ikea-lisp-code/diodberg/schematics/README.md

# diodberg schematics

diodberg schematics require Eagle v6.3.0 or later

...filenames will be cleaned up soon...

# Questions? 

Email <chris@notspelledright.com>, <yuanyu.chen@gmail.com>
