ikea-lisp-code/diodberg/schematics/dmx_splitter.brd

## EAGLE design schematics/dmx_splitter.brd (2013-07-26)

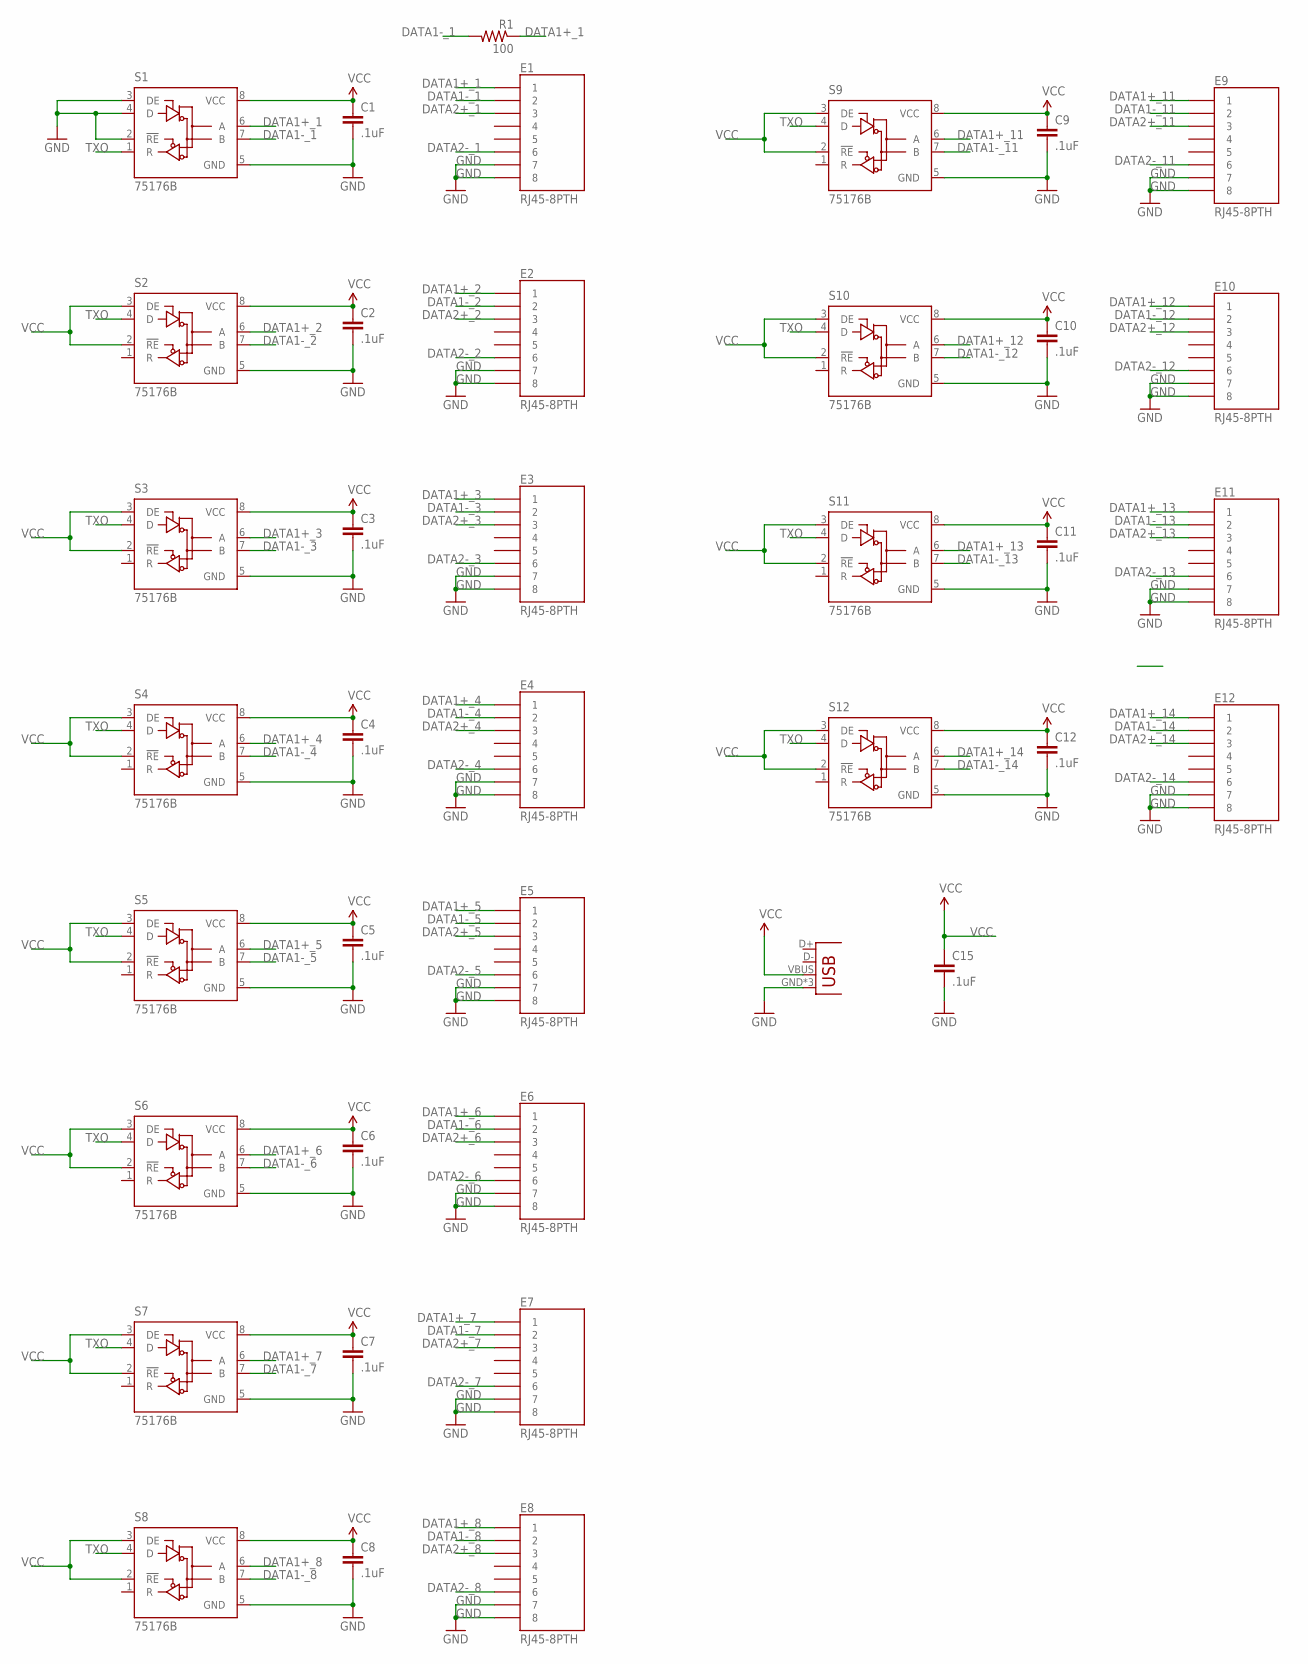
[picture p1: schematic dmx_splitter.sch]

Parts:
C1, C2, C3, C4, C5, C6, C7, C8, C9, C10, C11, C12, C15: .1uF; 0402-CAP
E1, E2, E3, E4, E5, E6, E7, E8, E9, E10, E11, E12: RJ45-8PTH; RJ45-8
JP1: USB-MICROB
R1: 100; 1206
S1, S2, S3, S4, S5, S6, S7, S8, S9, S10, S11, S12: 75176B; D_R-PDSO-G8

Connections:
DATA1+_1: E1.1, R1.1, S1.6 (A)
DATA1+_2: E2.1, S2.6 (A)
DATA1+_3: E3.1, S3.6 (A)
DATA1+_4: E4.1, S4.6 (A)
DATA1+_5: E5.1, S5.6 (A)
DATA1+_6: E6.1, S6.6 (A)
DATA1+_7: E7.1, S7.6 (A)
DATA1+_8: E8.1, S8.6 (A)
DATA1+_11: E9.1, S9.6 (A)
DATA1+_12: E10.1, S10.6 (A)
DATA1+_13: E11.1, S11.6 (A)
DATA1+_14: E12.1, S12.6 (A)
DATA1-_1: E1.2, R1.2, S1.7 (B)
DATA1-_2: E2.2, S2.7 (B)
DATA1-_3: E3.2, S3.7 (B)
DATA1-_4: E4.2, S4.7 (B)
DATA1-_5: E5.2, S5.7 (B)
DATA1-_6: E6.2, S6.7 (B)
DATA1-_7: E7.2, S7.7 (B)
DATA1-_8: E8.2, S8.7 (B)
DATA1-_11: E9.2, S9.7 (B)
DATA1-_12: E10.2, S10.7 (B)
DATA1-_13: E11.2, S11.7 (B)
DATA1-_14: E12.2, S12.7 (B)
DATA2+_1: E1.3
DATA2+_2: E2.3
DATA2+_3: E3.3
DATA2+_4: E4.3
DATA2+_5: E5.3
DATA2+_6: E6.3
DATA2+_7: E7.3
DATA2+_8: E8.3
DATA2+_11: E9.3
DATA2+_12: E10.3
DATA2+_13: E11.3
DATA2+_14: E12.3
DATA2-_1: E1.6
DATA2-_2: E2.6
DATA2-_3: E3.6
DATA2-_4: E4.6
DATA2-_5: E5.6
DATA2-_6: E6.6
DATA2-_7: E7.6
DATA2-_8: E8.6
DATA2-_11: E9.6
DATA2-_12: E10.6
DATA2-_13: E11.6
DATA2-_14: E12.6
GND: C1.2, C2.2, C3.2, C4.2, C5.2, C6.2, C7.2, C8.2, C9.2, C10.2, C11.2, C12.2, C15.2, E1.7, E1.8, E2.7, E2.8, E3.7, E3.8, E4.7, E4.8, E5.7, E5.8, E6.7, E6.8, E7.7, E7.8, E8.7, E8.8, E9.7, E9.8, E10.7, E10.8, E11.7, E11.8, E12.7, E12.8, JP1.GND, JP1.MT1 (GND), JP1.MT2 (GND), S1.2 (!RE), S1.3 (DE), S1.4 (D), S1.5 (GND), S2.5 (GND), S3.5 (GND), S4.5 (GND), S5.5 (GND), S6.5 (GND), S7.5 (GND), S8.5 (GND), S9.5 (GND), S10.5 (GND), S11.5 (GND), S12.5 (GND)
TXO: S1.1 (R), S2.4 (D), S3.4 (D), S4.4 (D), S5.4 (D), S6.4 (D), S7.4 (D), S8.4 (D), S9.4 (D), S10.4 (D), S11.4 (D), S12.4 (D)
VCC: C1.1, C2.1, C3.1, C4.1, C5.1, C6.1, C7.1, C8.1, C9.1, C10.1, C11.1, C12.1, C15.1, JP1.VBUS, S1.8 (VCC), S2.2 (!RE), S2.3 (DE), S2.8 (VCC), S3.2 (!RE), S3.3 (DE), S3.8 (VCC), S4.2 (!RE), S4.3 (DE), S4.8 (VCC), S5.2 (!RE), S5.3 (DE), S5.8 (VCC), S6.2 (!RE), S6.3 (DE), S6.8 (VCC), S7.2 (!RE), S7.3 (DE), S7.8 (VCC), S8.2 (!RE), S8.3 (DE), S8.8 (VCC), S9.2 (!RE), S9.3 (DE), S9.8 (VCC), S10.2 (!RE), S10.3 (DE), S10.8 (VCC), S11.2 (!RE), S11.3 (DE), S11.8 (VCC), S12.2 (!RE), S12.3 (DE), S12.8 (VCC)

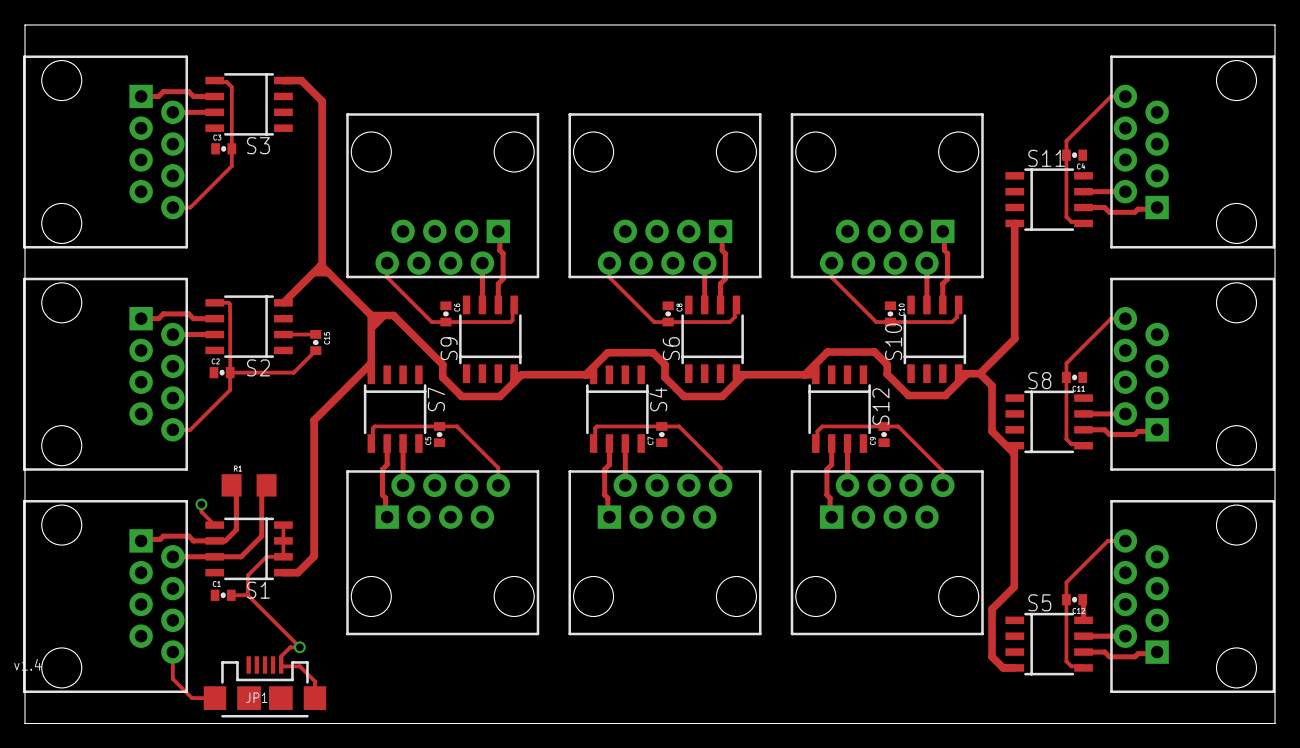
[picture p2: board dmx_splitter.brd from above]

Board: 2 copper layers, 100.0 x 55.9 mm, 39 parts (0 on the bottom side), 27 nets.
