ikea-lisp-code/diodberg/schematics/control_board_WS2812.brd

## EAGLE design schematics/control_board_WS2812.brd (2013-07-20)

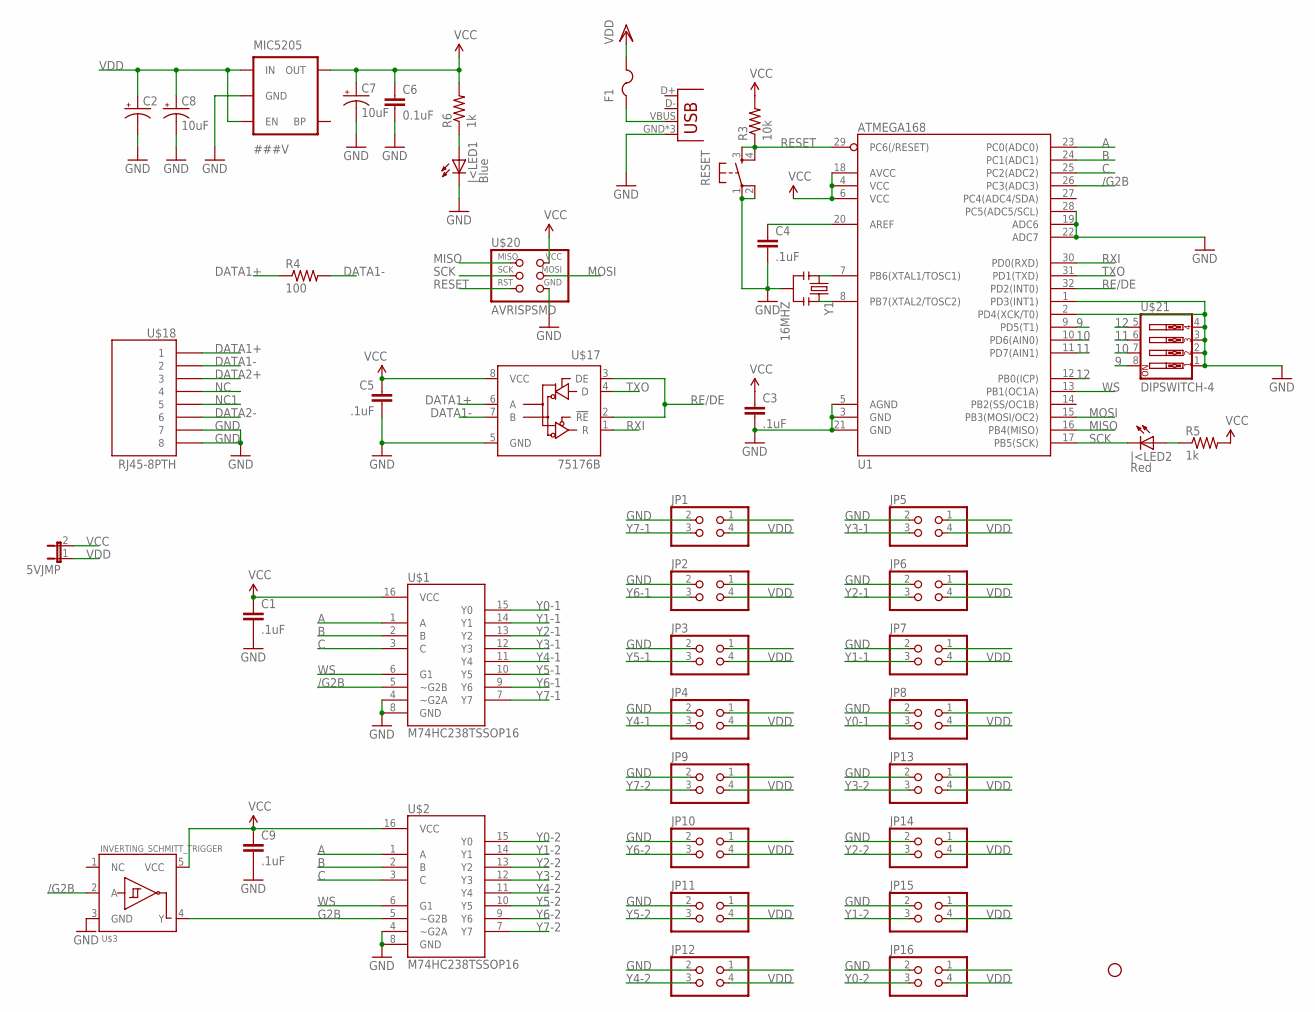
[picture p3: schematic control_board_WS2812.sch]

Parts:
5VJMP: JUMPER-2SMD-NO; SJ_2S-NO
C1, C3, C4, C5, C9: .1uF; 0402-CAP
C2: CAP_POLC; PANASONIC_C
C6: 0.1uF; 0402-CAP
C7, C8: 10uF; EIA3216
F1: PTCFUSE-1812; 1812
JP1, JP2, JP3, JP4, JP5, JP6, JP7, JP8, JP9, JP10, JP11, JP12, JP13, JP14, JP15, JP16: PINHD-2X2; 2X02
JP17: USB-MICROB
MIC5205: ###V; SOT23-5
R3: 10k; 0402-RES
R4: 100; 1206
R5, R6: 1k; C0402
RESET: TAC_SWITCHSMD; TACTILE_SWITCH_SMD
STANDOFF1: STAND-OFF
U1: ATMEGA168; TQFP32-08
U$1, U$2: M74HC238TSSOP16; TSSOP16
U$3: INVERTING_SCHMITT_TRIGGER; TSSOP5
U$17: 75176B; D_R-PDSO-G8
U$18: RJ45-8PTH; RJ45-8
U$20: AVRISPSMD; 2X03SMD
U$21: DIPSWITCH-4; DIPSWITCH-04
Y1: 16MHZ; RESONATOR-SMD
|<LED1: Blue; LED-0603
|<LED2: Red; LED-0603

Connections:
9: U1.9 (PD5(T1)), U$21.8
10: U1.10 (PD6(AIN0)), U$21.7
11: U1.11 (PD7(AIN1)), U$21.6
12: U1.12 (PB0(ICP)), U$21.5
/G2B: U1.26 (PC3(ADC3)), U$1.5 (~G2B), U$3.2 (A)
A: U1.23 (PC0(ADC0)), U$1.1 (A), U$2.1 (A)
B: U1.24 (PC1(ADC1)), U$1.2 (B), U$2.2 (B)
C: U1.25 (PC2(ADC2)), U$1.3 (C), U$2.3 (C)
DATA1+: R4.1, U$17.6 (A), U$18.1
DATA1-: R4.2, U$17.7 (B), U$18.2
DATA2+: U$18.3
DATA2-: U$18.6
G2B: U$2.5 (~G2B), U$3.4 (Y)
GND: C1.2, C2.-, C3.2, C4.2, C5.2, C6.2, C7.C (-), C8.C (-), C9.2, JP1.2, JP2.2, JP3.2, JP4.2, JP5.2, JP6.2, JP7.2, JP8.2, JP9.2, JP10.2, JP11.2, JP12.2, JP13.2, JP14.2, JP15.2, JP16.2, JP17.GND, JP17.MT1 (GND), JP17.MT2 (GND), MIC5205.2 (GND), RESET.1, RESET.2, U1.1 (PD3(INT1)), U1.2 (PD4(XCK/T0)), U1.3 (GND), U1.5 (AGND), U1.19 (ADC6), U1.21 (GND), U1.22 (ADC7), U1.28 (PC5(ADC5/SCL)), U$1.4 (~G2A), U$1.8 (GND), U$2.4 (~G2A), U$2.8 (GND), U$3.3 (GND), U$17.5 (GND), U$18.7, U$18.8, U$20.6 (GND), U$21.1, U$21.2, U$21.3, U$21.4, Y1.2, |<LED1.C
MISO: U1.16 (PB4(MISO)), U$20.1 (MISO)
MOSI: U1.15 (PB3(MOSI/OC2)), U$20.4 (MOSI)
unnamed: C4.1, U1.20 (AREF)
unnamed: U1.7 (PB6(XTAL1/TOSC1)), Y1.1
unnamed: U1.8 (PB7(XTAL2/TOSC2)), Y1.3
unnamed: R5.1, |<LED2.A
unnamed: F1.1, JP17.VBUS
unnamed: R6.1, |<LED1.A
NC: U$18.4
NC1: U$18.5
RE/DE: U1.32 (PD2(INT0)), U$17.2 (!RE), U$17.3 (DE)
RESET: R3.1, RESET.3, RESET.4, U1.29 (PC6(/RESET)), U$20.5 (RST)
RXI: U1.30 (PD0(RXD)), U$17.1 (R)
SCK: U1.17 (PB5(SCK)), U$20.3 (SCK), |<LED2.C
TXO: U1.31 (PD1(TXD)), U$17.4 (D)
VCC: 5VJMP.2, C1.1, C3.1, C5.1, C6.1, C7.A (+), C9.1, MIC5205.5 (OUT), R3.2, R5.2, R6.2, U1.4 (VCC), U1.6 (VCC), U1.18 (AVCC), U$1.16 (VCC), U$2.16 (VCC), U$3.5 (VCC), U$17.8 (VCC), U$20.2 (VCC)
VDD: 5VJMP.1, C2.+, C8.A (+), F1.2, JP1.4, JP2.4, JP3.4, JP4.4, JP5.4, JP6.4, JP7.4, JP8.4, JP9.4, JP10.4, JP11.4, JP12.4, JP13.4, JP14.4, JP15.4, JP16.4, MIC5205.1 (IN), MIC5205.3 (EN)
WS: U1.13 (PB1(OC1A)), U$1.6 (G1), U$2.6 (G1)
Y0-1: JP8.3, U$1.15 (Y0)
Y0-2: JP16.3, U$2.15 (Y0)
Y1-1: JP7.3, U$1.14 (Y1)
Y1-2: JP15.3, U$2.14 (Y1)
Y2-1: JP6.3, U$1.13 (Y2)
Y2-2: JP14.3, U$2.13 (Y2)
Y3-1: JP5.3, U$1.12 (Y3)
Y3-2: JP13.3, U$2.12 (Y3)
Y4-1: JP4.3, U$1.11 (Y4)
Y4-2: JP12.3, U$2.11 (Y4)
Y5-1: JP3.3, U$1.10 (Y5)
Y5-2: JP11.3, U$2.10 (Y5)
Y6-1: JP2.3, U$1.9 (Y6)
Y6-2: JP10.3, U$2.9 (Y6)
Y7-1: JP1.3, U$1.7 (Y7)
Y7-2: JP9.3, U$2.7 (Y7)

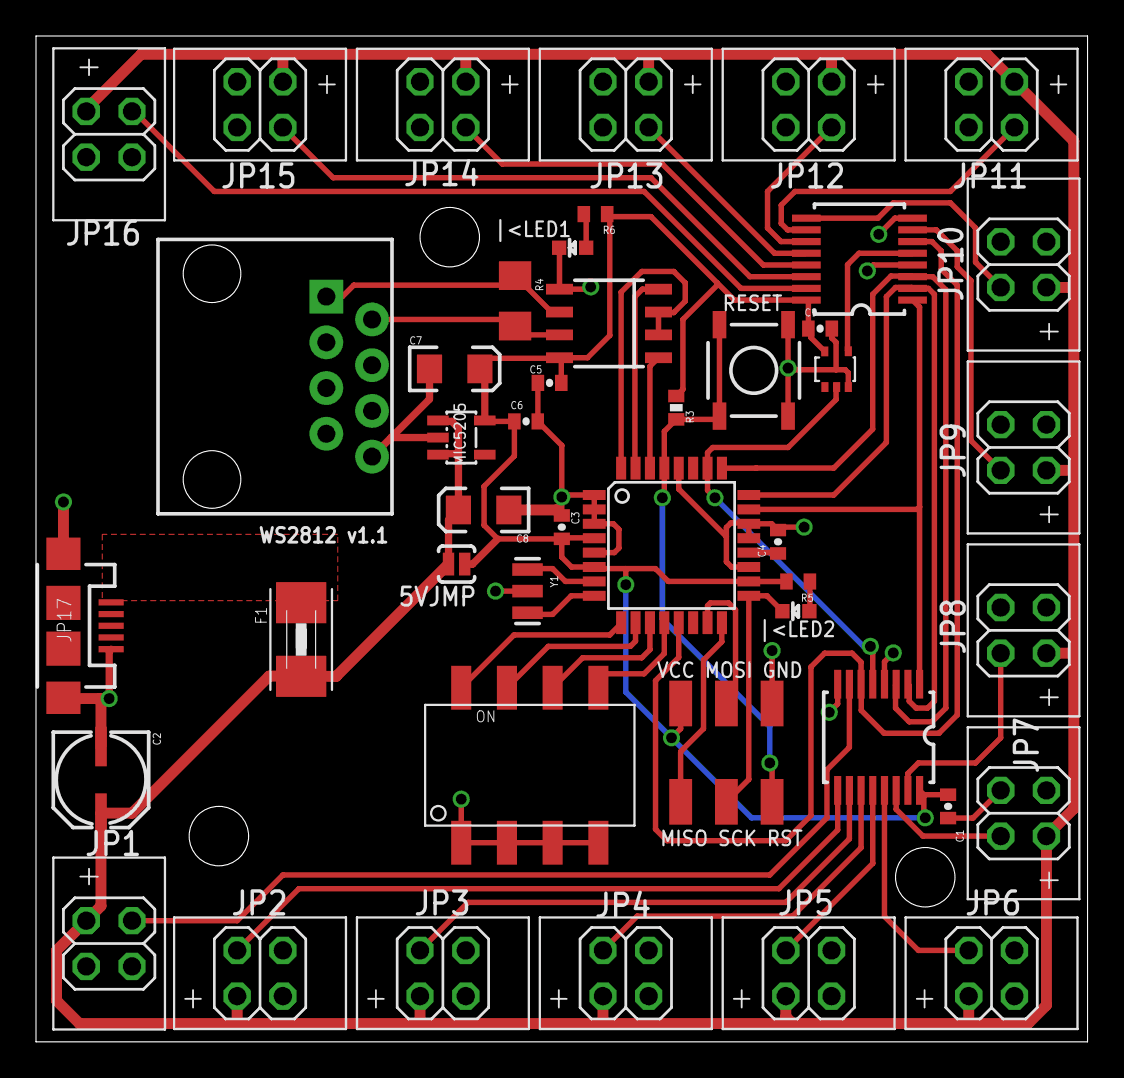
[picture p4: board control_board_WS2812.brd from above]

Board: 2 copper layers, 58.4 x 55.9 mm, 48 parts (0 on the bottom side), 44 nets.

Other parts of the board:
STANDOFF2, STANDOFF3: STAND-OFF
