ikea-lisp-code/diodberg/schematics/climbing_WS2812.brd

## EAGLE design schematics/climbing_WS2812.brd (2013-07-14)

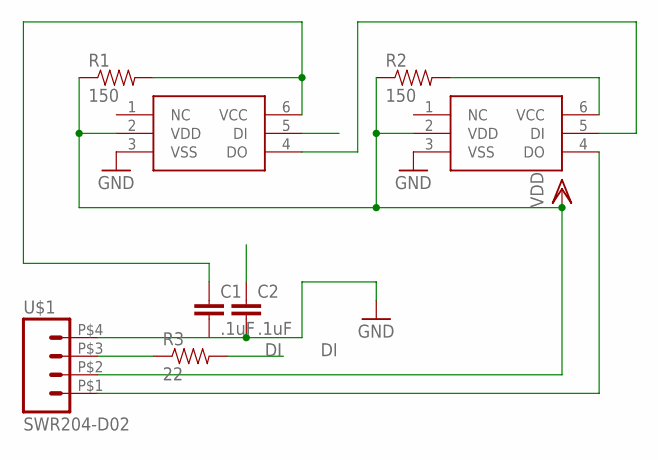
[picture p5: schematic climbing_WS2812.sch]

Parts:
C1, C2: .1uF; 0603-CAP
R1, R2: 150; 0603-RES
R3: 22; 0603-RES
U$1: SWR204-D02; SWR204
U$2, U$3: WS2812; RGBLED5050

Connections:
DI: R3.2, U$2.5 (DI)
DODI: U$2.4 (DO), U$3.5 (DI)
GND: C1.2, C2.2, U$1.P$4 (4), U$2.3 (VSS), U$3.3 (VSS)
unnamed: R3.1, U$1.P$3 (3)
unnamed: U$1.P$1 (1), U$3.4 (DO)
VCC: C1.1, R1.2, U$2.6 (VCC)
VCC2: C2.1, R2.2, U$3.6 (VCC)
VDD: R1.1, R2.1, U$1.P$2 (2), U$2.2 (VDD), U$3.2 (VDD)

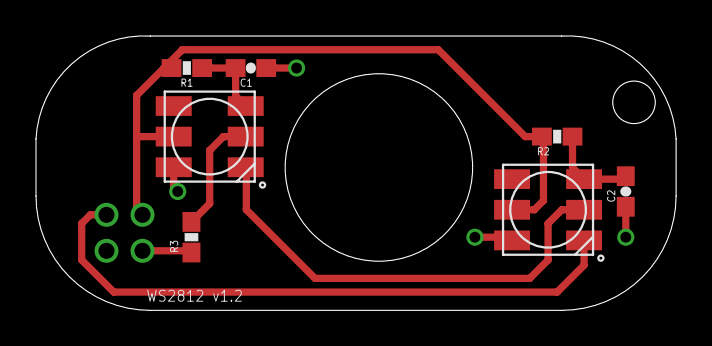
[picture p6: board climbing_WS2812.brd from above]

Board: 2 copper layers, 35.6 x 15.2 mm, 8 parts (1 on the bottom side), 8 nets.
