ikea-lisp-code/diodberg/schematics/climbingRGB_bolt.brd

## EAGLE design schematics/climbingRGB_bolt.brd (2013-07-14)

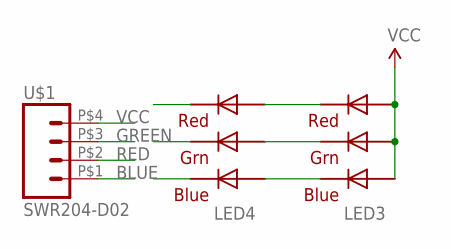
[picture p7: schematic climbingRGB_bolt.sch]

Parts:
LED3, LED4: RGBLED5050
U$1: SWR204-D02; SWR204

Connections:
BLUE: LED4.4 (BLUE_C), U$1.P$1 (1)
GREEN: LED4.6 (GREEN_C), U$1.P$3 (3)
unnamed: LED3.4 (BLUE_C), LED4.3 (BLUE_A)
unnamed: LED3.6 (GREEN_C), LED4.1 (GREEN_A)
unnamed: LED3.5 (RED_C), LED4.2 (RED_A)
RED: LED4.5 (RED_C), U$1.P$2 (2)
VCC: LED3.1 (GREEN_A), LED3.2 (RED_A), LED3.3 (BLUE_A), U$1.P$4 (4)

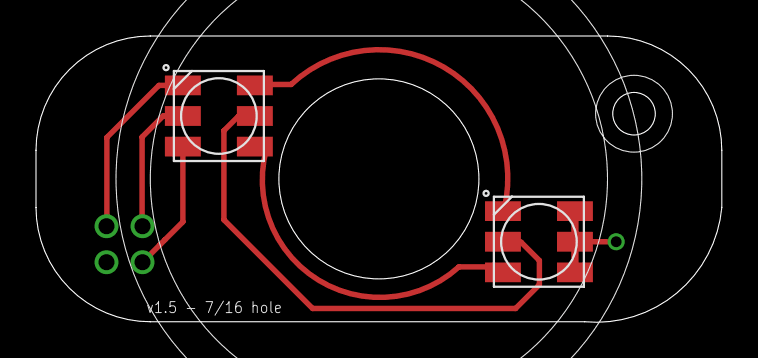
[picture p8: board climbingRGB_bolt.brd from above]

Board: 2 copper layers, 38.1 x 15.9 mm, 3 parts (1 on the bottom side), 7 nets.
