ikea-lisp-code/diodberg/schematics/ATTINY_WS2812.brd

## EAGLE design schematics/ATTINY_WS2812.brd (2013-07-14)

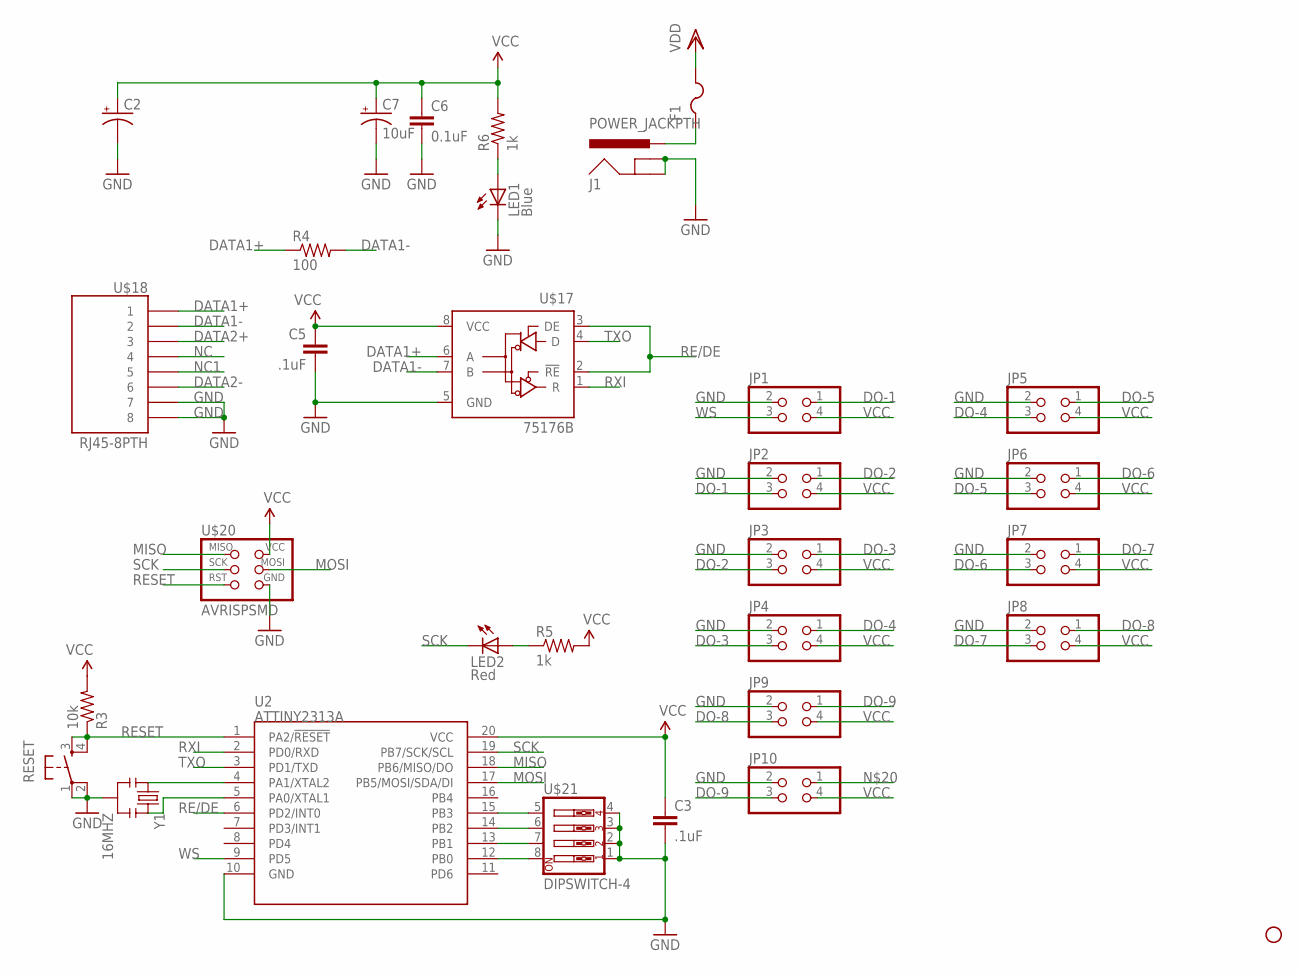
[picture p9: schematic ATTINY_WS2812.sch]

Parts:
C2: CAP_POLC; PANASONIC_C
C3, C5: .1uF; 0402-CAP
C6: 0.1uF; 0402-CAP
C7: 10uF; EIA3216
F1: PTCFUSE-1812; 1812
J1: POWER_JACKPTH; POWER_JACK_PTH
JP1, JP2, JP3, JP4, JP5, JP6, JP7, JP8, JP9, JP10: PINHD-2X2; 2X02
LED1: Blue; LED-0603
LED2: Red; LED-0603
R3: 10k; 0402-RES
R4: 100; 1206
R5, R6: 1k; C0402
RESET: TAC_SWITCHSMD; TACTILE_SWITCH_SMD
STANDOFF1: STAND-OFF
U2: ATTINY2313A; SOP20W
U$17: 75176B; D_R-PDSO-G8
U$18: RJ45-8PTH; RJ45-8
U$20: AVRISPSMD; 2X03SMD
U$21: DIPSWITCH-4; DIPSWITCH-04
Y1: 16MHZ; RESONATOR-SMD

Connections:
DATA1+: R4.1, U$17.6 (A), U$18.1
DATA1-: R4.2, U$17.7 (B), U$18.2
DATA2+: U$18.3
DATA2-: U$18.6
DO-1: JP1.1, JP2.3
DO-2: JP2.1, JP3.3
DO-3: JP3.1, JP4.3
DO-4: JP4.1, JP5.3
DO-5: JP5.1, JP6.3
DO-6: JP6.1, JP7.3
DO-7: JP7.1, JP8.3
DO-8: JP8.1, JP9.3
DO-9: JP9.1, JP10.3
GND: C2.-, C3.2, C5.2, C6.2, C7.C (-), J1.GND, J1.GNDBREAK, JP1.2, JP2.2, JP3.2, JP4.2, JP5.2, JP6.2, JP7.2, JP8.2, JP9.2, JP10.2, LED1.C, RESET.1, RESET.2, U2.10 (GND), U$17.5 (GND), U$18.7, U$18.8, U$20.6 (GND), U$21.1, U$21.2, U$21.3, U$21.4, Y1.2
MISO: U2.18 (PB6/MISO/DO), U$20.1 (MISO)
MOSI: U2.17 (PB5/MOSI/SDA/DI), U$20.4 (MOSI)
unnamed: U2.15 (PB3), U$21.5
unnamed: U2.5 (PA0/XTAL1), Y1.3
unnamed: U2.14 (PB2), U$21.6
unnamed: U2.4 (PA1/XTAL2), Y1.1
unnamed: U2.13 (PB1), U$21.7
unnamed: LED2.A, R5.1
unnamed: F1.1, J1.PWR
unnamed: U2.12 (PB0), U$21.8
unnamed: LED1.A, R6.1
NC: U$18.4
NC1: U$18.5
RE/DE: U2.6 (PD2/INT0), U$17.2 (!RE), U$17.3 (DE)
RESET: R3.1, RESET.3, RESET.4, U2.1 (PA2/!RESET), U$20.5 (RST)
RXI: U2.2 (PD0/RXD), U$17.1 (R)
SCK: LED2.C, U2.19 (PB7/SCK/SCL), U$20.3 (SCK)
TXO: U2.3 (PD1/TXD), U$17.4 (D)
VCC: C2.+, C3.1, C5.1, C6.1, C7.A (+), F1.2, JP1.4, JP2.4, JP3.4, JP4.4, JP5.4, JP6.4, JP7.4, JP8.4, JP9.4, JP10.4, R3.2, R5.2, R6.2, U2.20 (VCC), U$17.8 (VCC), U$20.2 (VCC)
WS: JP1.3, U2.9 (PD5)

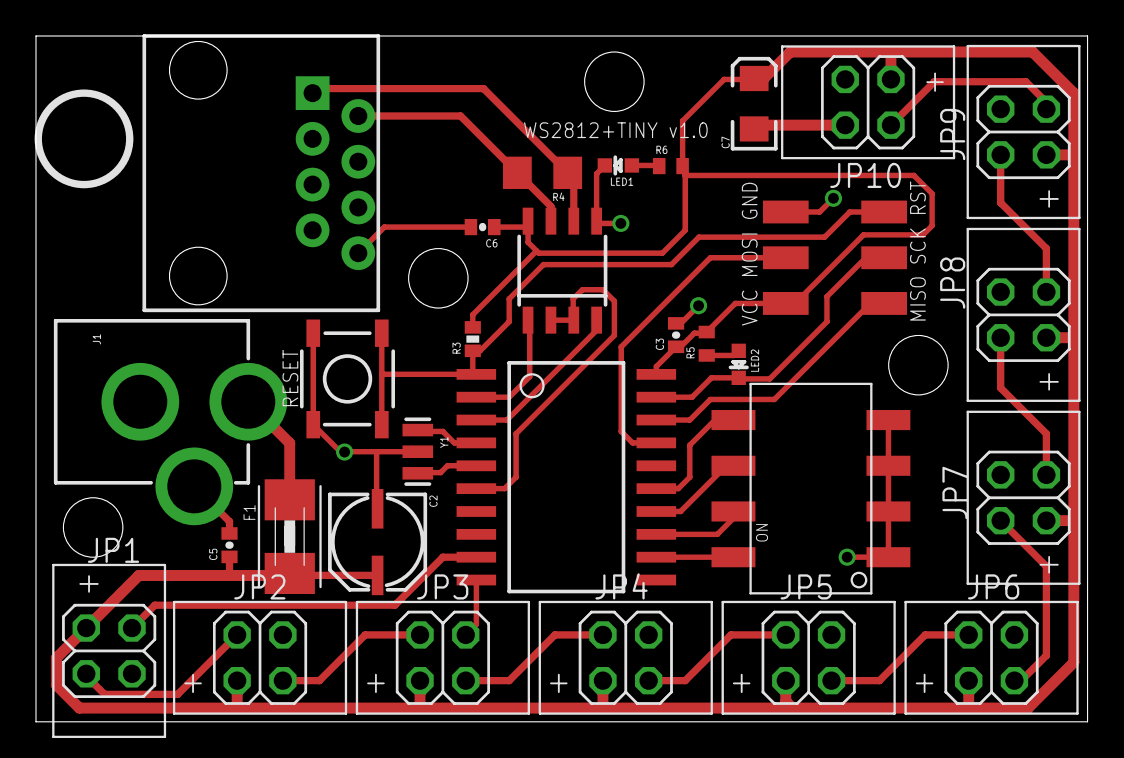
[picture p10: board ATTINY_WS2812.brd from above]

Board: 2 copper layers, 58.4 x 38.1 mm, 34 parts (0 on the bottom side), 30 nets.

Other parts of the board:
STANDOFF2, STANDOFF3, STANDOFF4: STAND-OFF
