ikea-lisp-code/diodberg/schematics/control_board.brd

## EAGLE design schematics/control_board.brd (2013-06-05)

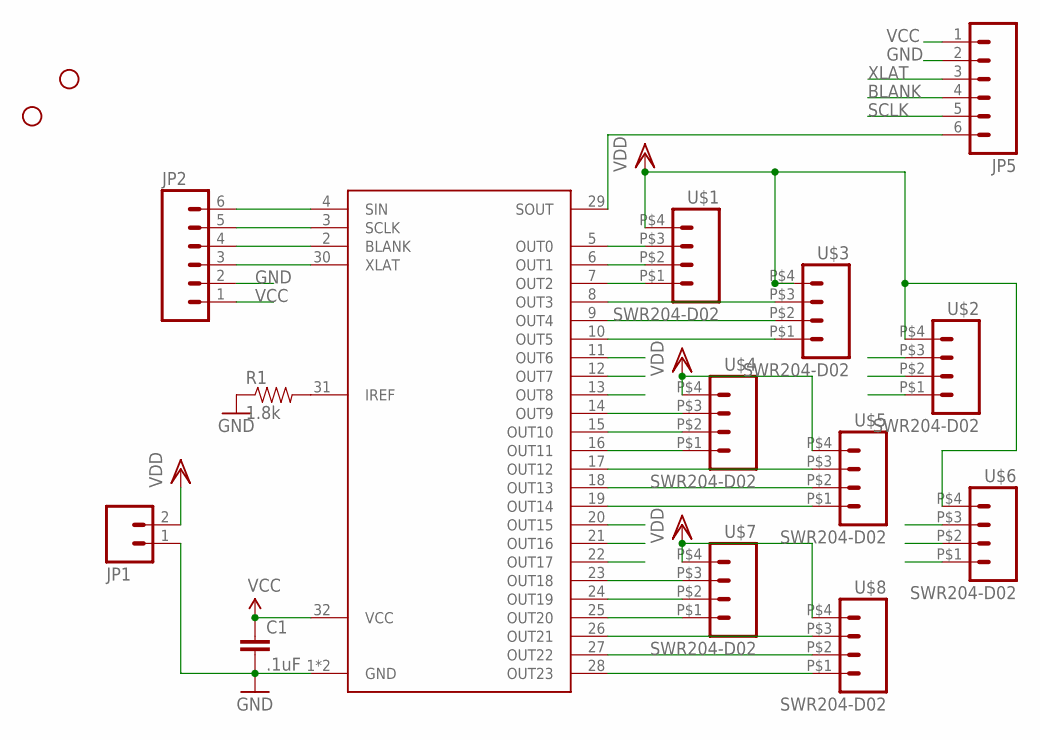
[picture p11: schematic control_board.sch]

Parts:
C1: .1uF; 0603-CAP
JP1: M02-JST-2MM-SMT; JST-2-SMD
JP2, JP5: M06LOCK; 1X06_LOCK
R1: 1.8k; 0603-RES
STANDOFF2, STANDOFF3: STAND-OFF
TLC5947: TLC5947DAP; DAP
U$1, U$2, U$3, U$4, U$5, U$6, U$7, U$8: SWR204-D02; SWR204

Connections:
BLANK: JP2.4, JP5.4, TLC5947.2 (BLANK)
GND: C1.2, JP1.1 (2), JP2.2, JP5.2, R1.1, TLC5947.1 (GND), TLC5947.GND
unnamed: R1.2, TLC5947.31 (IREF)
OUT0: TLC5947.5 (OUT0), U$1.P$3 (3)
OUT1: TLC5947.6 (OUT1), U$1.P$2 (2)
OUT2: TLC5947.7 (OUT2), U$1.P$1 (1)
OUT3: TLC5947.8 (OUT3), U$3.P$3 (3)
OUT4: TLC5947.9 (OUT4), U$3.P$2 (2)
OUT5: TLC5947.10 (OUT5), U$3.P$1 (1)
OUT6: TLC5947.11 (OUT6), U$2.P$3 (3)
OUT7: TLC5947.12 (OUT7), U$2.P$2 (2)
OUT8: TLC5947.13 (OUT8), U$2.P$1 (1)
OUT9: TLC5947.14 (OUT9), U$4.P$3 (3)
OUT10: TLC5947.15 (OUT10), U$4.P$2 (2)
OUT11: TLC5947.16 (OUT11), U$4.P$1 (1)
OUT12: TLC5947.17 (OUT12), U$5.P$3 (3)
OUT13: TLC5947.18 (OUT13), U$5.P$2 (2)
OUT14: TLC5947.19 (OUT14), U$5.P$1 (1)
OUT15: TLC5947.20 (OUT15), U$6.P$3 (3)
OUT16: TLC5947.21 (OUT16), U$6.P$2 (2)
OUT17: TLC5947.22 (OUT17), U$6.P$1 (1)
OUT18: TLC5947.23 (OUT18), U$7.P$3 (3)
OUT19: TLC5947.24 (OUT19), U$7.P$2 (2)
OUT20: TLC5947.25 (OUT20), U$7.P$1 (1)
OUT21: TLC5947.26 (OUT21), U$8.P$3 (3)
OUT22: TLC5947.27 (OUT22), U$8.P$2 (2)
OUT23: TLC5947.28 (OUT23), U$8.P$1 (1)
SCLK: JP2.5, JP5.5, TLC5947.3 (SCLK)
SIN: JP2.6, TLC5947.4 (SIN)
SOUT: JP5.6, TLC5947.29 (SOUT)
VCC: C1.1, JP2.1, JP5.1, TLC5947.32 (VCC)
VDD: JP1.2 (1), U$1.P$4 (4), U$2.P$4 (4), U$3.P$4 (4), U$4.P$4 (4), U$5.P$4 (4), U$6.P$4 (4), U$7.P$4 (4), U$8.P$4 (4)
XLAT: JP2.3, JP5.3, TLC5947.30 (XLAT)

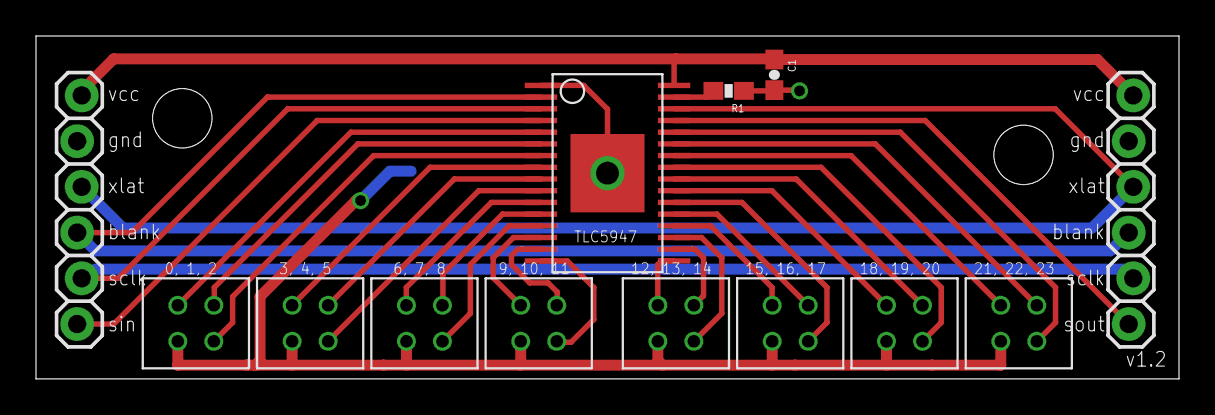
[picture p12: board control_board.brd from above]

Board: 2 copper layers, 63.5 x 19.1 mm, 16 parts (1 on the bottom side), 33 nets.
