ikea-lisp-code/diodberg/schematics/ethernet_switch_single.brd

## EAGLE design schematics/ethernet_switch_single.brd (2013-06-05)

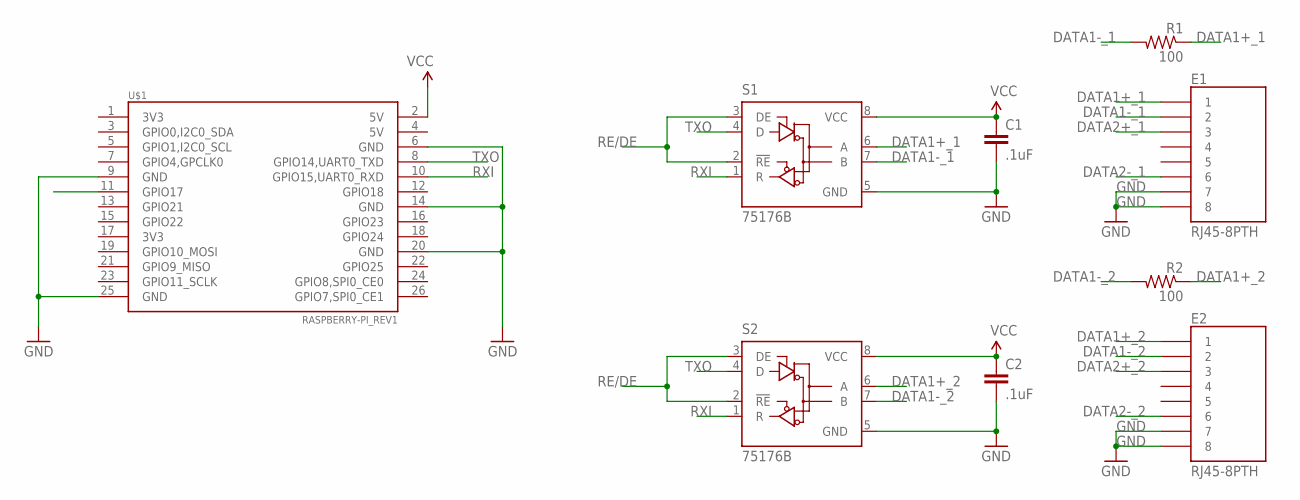
[picture p13: schematic ethernet_switch_single.sch]

Parts:
C1, C2: .1uF; 0402-CAP
E1, E2: RJ45-8PTH; RJ45-8
R1, R2: 100; 1206
S1, S2: 75176B; D_R-PDSO-G8
U$1: RASPBERRY-PI_REV1

Connections:
DATA1+_1: E1.1, R1.1, S1.6 (A)
DATA1+_2: E2.1, R2.1, S2.6 (A)
DATA1-_1: E1.2, R1.2, S1.7 (B)
DATA1-_2: E2.2, R2.2, S2.7 (B)
DATA2+_1: E1.3
DATA2+_2: E2.3
DATA2-_1: E1.6
DATA2-_2: E2.6
GND: C1.2, C2.2, E1.7, E1.8, E2.7, E2.8, S1.5 (GND), S2.5 (GND), U$1.6 (GND), U$1.9 (GND), U$1.14 (GND), U$1.20 (GND), U$1.25 (GND)
RE/DE: S1.2 (!RE), S1.3 (DE), S2.2 (!RE), S2.3 (DE), U$1.11 (GPIO17)
RXI: S1.1 (R), S2.1 (R), U$1.10 (GPIO15,UART0_RXD)
TXO: S1.4 (D), S2.4 (D), U$1.8 (GPIO14,UART0_TXD)
VCC: C1.1, C2.1, S1.8 (VCC), S2.8 (VCC), U$1.2 (5V)

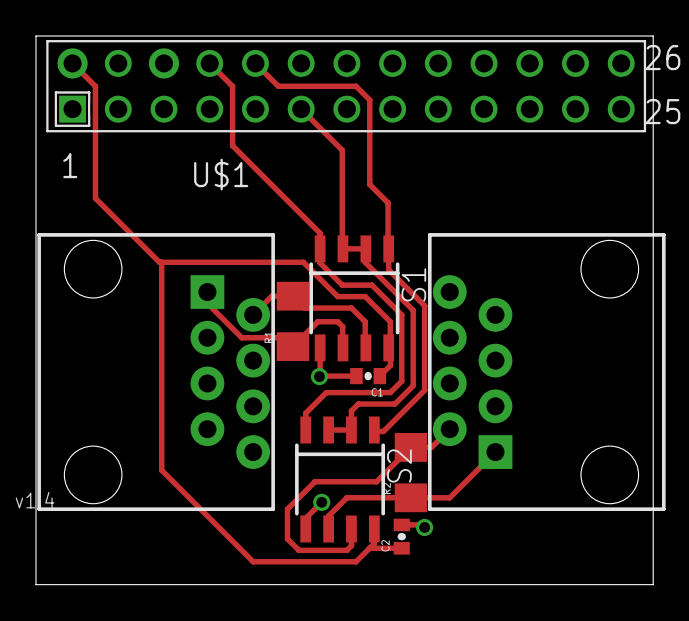
[picture p14: board ethernet_switch_single.brd from above]

Board: 2 copper layers, 34.3 x 30.5 mm, 9 parts (0 on the bottom side), 9 nets.
