ikea-lisp-code/diodberg/(commit log)

2013-05-09 deleted pogo pin board
    [climbingRGB_pogo.brd, climbingRGB_pogo.sch]
2013-05-17 minor edits
    - changed RGB board hole to 7/16"
    - minor edits to MCU board
    [climbingRGB.brd, control_board_MCU.brd, control_board_MCU.sch]
2013-05-29 PyGameRenderer and miscellaneous improvements: testing utilities, bug fixes, comments.
    [utils.py]
2013-05-30 Fixed package hierarchy, added manifest, tested module importing, fixed some stupid mistakes.
    [utils.py]
2013-05-31 pylint bugfixes. Test renderer works using the pygame renderer.
    [utils.py]
2013-06-04 RaspberryPi renderer for direct PWM GPIO and serial GPIO to WS2812.
2013-06-04 new things!
    [ATTINY_WS2812.brd, ATTINY_WS2812.sch, climbingRGB_bolt.brd, climbingRGB_bolt.sch, climbing_WS2812.sch, control_board_MCU.brd, control_board_WS2812.brd, control_board_WS2812.sch]
2013-06-04 DMX over serial renderer for the RaspberryPi.
2013-06-04 Bug fix in last commit.
    [utils.py]
2013-06-04 attiny2313 control board
    [ATTINY_WS2812.brd, ATTINY_WS2812.sch]
2013-06-04 minor edit to attiny board
    [ATTINY_WS2812.brd]
2013-06-05 Oh sweet RaspberryPi, you whisper such sweet nothings in my ear, like _250kilobaud? Your wish is my command._ LIES. POISON. PySerialRender is now patched to run at pyserial's max clock.
2013-06-05 Arduino, whyyyyyyy?
2013-06-06 Broke renderers out into separate files, added some performance improvements.
    [gpio_renderers.py, serial_renderers.py, serial_utils.py, simulation_renderers.py]
2013-06-06 added anti-spinning technology
    [climbing_WS2812.brd, climbing_WS2812.sch]
2013-06-06 More optimizations, refactoring (removed redundant datatypes), and fixed executable bug.
    [gpio_renderers.py, serial_renderers.py, serial_utils.py, simulation_renderers.py, utils.py]
2013-06-09 Added num_pixels parameter to serial renderer executable and fixed random_panel() to assign DMX addresses.
    [serial_renderers.py, utils.py]
2013-06-16 Adding alternate driver architecture.
2013-06-29 Combine DMX and demo mode for WS2811 LED driver boards.
2013-06-29 Convert TLC driver board code to use DMX address and have a demo mode.
2013-07-14 changed WS2812 controller to uUSB, minor spacing edits to everything else
    [ATTINY_WS2812.brd, climbingRGB_bolt.brd, climbing_WS2812.brd, control_board_MCU.brd, control_board_WS2812.brd, control_board_WS2812.sch]
2013-07-15 added full ethernet switch board (unfinished), modified WS2812 controller
    [control_board_WS2812.brd, ethernet_switch.brd, ethernet_switch.sch]
2013-07-20 minor tweaks
    [control_board_WS2812.brd]
2013-07-25 Made DMX splitter board for RPi -> other boards. iff --git a/schematics/dmx_splitter.brd b/schematics/dmx_splitter.brd new file mode 100644 index 0000000..f48532d --- /dev/null +++ b/schematics/dmx_s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
    [dmx_splitter.brd, dmx_splitter.sch, ethernet_switch.brd]
2013-07-26 made board 10cm wide
    [dmx_splitter.brd]
2013-07-26 Remove negative offset on board edge...
    [dmx_splitter.brd]
2013-08-02 Added data configuration file. Merging in changes and pushing into a temporarily broken state.
    [simulation_renderers.py, utils.py]
